tnguyenmanht-arch/amr_ws/docs/wiring-f411.html

AMR Ackermann — HUST Automotive Engineering

# Sơ đồ đấu dây STM32F411 (Black Pill)

Driver motor: DRV8871 ×2 (thay BTS7960). Servo: qua board debug TTL bus servo (thay lối đấu điện trở tạm). Tổng hợp toàn bộ pin, phân phối nguồn, và cách nối GND kiểu star — làm đúng thứ tự, không rút gọn bước nào.

2026-08-15 — Đổi driver BTS7960 → DRV8871, servo quay lại dùng board debug TTL

DRV8871 không có R_EN/L_EN (chỉ IN1/IN2 + VM/GND + OUT1/OUT2 qua terminal vít) — bỏ hẳn rail 5V từng nuôi riêng cho R_EN/L_EN của BTS7960.

Firmware không đổi gì: motor_driver.c vốn điều khiển kiểu "PWM 1 chân, chân kia = 0" — DRV8871 IN1/IN2 dùng đúng interface này. servo_buslinker.c vốn gửi khung BusLinker qua USART1, đúng giao thức board debug hiểu — lối đấu điện trở trước đây chỉ là bản chữa cháy khi board debug gốc hỏng.

⚠️ Board debug servo (BusLinker-V2.5) — KHÔNG cấp 5V ngoài vào chân 5V header

Theo user manual chính hãng (reference/TTL Bus Servo Debugging Board/): board chỉ có 1 đường nguồn vào duy nhất — terminal vít Vin (5~14V) + GND. Header 4 chân 5V TX RX GND là cổng nối vi điều khiển ngoài — chân 5V ở đây là OUTPUT do IC ổn áp trên board tự tạo ra từ Vin, không phải input cần cấp nguồn.

Nếu bơm thêm nguồn 5V ngoài vào chân này, nguồn ngoài sẽ đấu đối đầu với chính IC ổn áp trên board (2 nguồn cùng cố giữ 1 điểm ở 2 giá trị) → có thể hỏng IC ổn áp. Chỉ cấp Vin/GND qua terminal, để trống chân 5V trên header. Module hạ áp 12V→5V dự phòng không cần dùng cho board này nữa.

Xác nhận trước khi tin hẳn: cấp riêng Vin/GND (chưa nối gì vào header) → đo chân 5V header, nếu tự ra ~5V mà chưa cấp gì vào đó thì đúng là output, an toàn để bỏ trống.

⚠️ Dây/đầu nối cho đường công suất — KHÔNG dùng dupont/breadboard

Phát hiện 2026-07-26 khi đấu lại board F411 (lúc còn dùng BTS7960): dây jumper/dupont (thường 26-28 AWG, đầu pin tiếp xúc diện tích nhỏ) không đủ tải dòng motor stall ~2.3A/con — gây giật cục tăng dần theo thời gian chạy (tiếp xúc kém → nóng → điện trở tăng → nóng hơn, vòng lặp tự làm xấu). Đúng gốc rễ y hệt vụ R_EN/L_EN lỏng trên F103 trước đó, chỉ khác biểu hiện. DRV8871 dùng terminal vít cho đúng các đường này nên đỡ rủi ro hơn, nhưng vẫn cần dây đủ to và vặn vít chặt.

Bắt buộc cho các đường sau: VM, GND, OUT1, OUT2 của cả 2 DRV8871, và terminal 12V của board debug servo:

- Dây tối thiểu 18-20 AWG (0.5-0.75mm²)
- Siết vít terminal chặt tay, kiểm tra lay thử không tuột — nếu không có terminal vít (đường nào vẫn phải dùng dupont) thì bắt buộc hàn

Dupont/breadboard chỉ nên dùng cho tín hiệu logic dòng thấp: PWM (PA6/PA7/PB0/PB1 → IN1/IN2), encoder, USART, SWD.

## 01Bảng chân STM32F411

Chân | Chức năng | Nối tới | Loại
PA6 | TIM3_CH1 | DRV8871 trái — IN1 | Signal
PA7 | TIM3_CH2 | DRV8871 trái — IN2 | Signal
PB0 | TIM3_CH3 | DRV8871 phải — IN1 | Signal
PB1 | TIM3_CH4 | DRV8871 phải — IN2 | Signal
PA0 | TIM2_CH1 | Encoder trái — kênh A | Signal
PA1 | TIM2_CH2 | Encoder trái — kênh B | Signal
PB6 | TIM4_CH1 | Encoder phải — kênh A (đổi từ PC6 trên F446) | Signal
PB7 | TIM4_CH2 | Encoder phải — kênh B (đổi từ PC7 trên F446) | Signal
PA9 | USART1_TX | Board debug servo — RX | Signal
PA10 | USART1_RX | Board debug servo — TX | Signal
PA2 | USART2_TX | Jetson RX / CH340 RX (lúc test) | Signal
PA3 | USART2_RX | Jetson TX / CH340 TX (lúc test) | Signal
SWCLK / SWDIO | SWD | ST-Link — nạp code | Signal
3V3 | VDD | ST-Link 3.3V — cấp nguồn logic cho chip | Power

## 02Nối GND kiểu Star

Không để dòng lớn (motor) và GND logic (STM32) đi chung 1 đoạn dây. Mỗi nhánh GND đi thẳng, riêng biệt về 1 thanh terminal block nhỏ (điểm gốc vật lý) — rồi chỉ 1 dây duy nhất từ thanh đó ra cực (–) thật của pin 12V. Đây là điểm khác biệt lớn nhất so với cách đấu cũ (GND đi xuyên qua chân board BTS7960 rồi mới ra pin — gây hỏng board 2 lần).

Thanh terminal GND (bus bar) — 1 dây duy nhất ra cực (–) Pin 12V

STM32 GNDdây riêng, không qua board nào khác

DRV8871 tráiGND

DRV8871 phảiGND

Board debug servoGND (1 dây, board tự lo GND cho servo)

Encoder trái GNDdây riêng

Encoder phải GNDdây riêng

6 nhánh độc lập — không nhánh nào nối tiếp qua nhánh khác trước khi về điểm gốc

Vì sao phải làm vậy

Nếu GND của STM32 đi chung dây với GND của board driver motor (nơi dòng motor lớn chạy qua), dòng lớn đó gây sụt áp cục bộ trên chính đoạn dây chung — điện thế "GND" mà STM32 nhìn thấy không còn thực sự là 0V nữa. Chênh lệch này tạo dòng rò qua chân GPIO, tích lũy nhiệt qua nhiều giờ test — nghi vấn chính cho việc hỏng 2 board STM32 F446 trước đây.

## 03Phân phối nguồn

Dùng breadboard/terminal nhỏ làm điểm chia cho mỗi rail — mỗi lỗ chỉ 1 dây, không nhét nhiều dây chung 1 lỗ.

Rail | Nguồn | Cấp cho
12V | Pin 3S2P (qua BMS) | VM DRV8871 trái · VM DRV8871 phải · Terminal Vin board debug servo (board tự hạ áp nội bộ, pass-through VIN servo)
5V | Không dùng nữa — DRV8871 không cần (không có R_EN/L_EN), board debug servo tự tạo 5V nội bộ từ Vin, không cần cấp ngoài (xem cảnh báo ở trên). Module hạ áp 12V→5V dự phòng, chưa cần dùng.
3.3V | ST-Link (chân 3V3 của Black Pill) | VCC encoder trái · VCC encoder phải
GND | Cực (–) pin 12V | Theo sơ đồ star ở mục 02 — không dùng rail chung kiểu daisy-chain

## 04Từng thiết bị

### DRV8871 — board trái

Terminal vít nguồn (VM/GND) có 2 vị trí/net mỗi loại (chỉ để tiện chain) — dùng 1 vị trí mỗi net là đủ, vị trí còn lại để trống.

VM | Rail 12V — terminal vít, dây ≥18-20 AWG
GND | Dây riêng → thanh terminal GND — terminal vít, dây ≥18-20 AWG
IN1 | PA6
IN2 | PA7
OUT1, OUT2 | 2 dây động lực motor trái (không phân biệt chiều) — terminal vít, dây ≥18-20 AWG

### DRV8871 — board phải

Giống hệt board trái, đổi IN1 → PB0, IN2 → PB1, OUT1/OUT2 → motor phải, GND vẫn là nhánh star riêng của board này.

### Encoder (đấu thẳng vào STM32, không qua DRV8871)

Dây | Trái | Phải
VCC | Rail 3.3V | Rail 3.3V
GND | Nhánh star riêng | Nhánh star riêng
Kênh A | PA0 | PB6
Kênh B | PA1 | PB7

### Board debug TTL bus servo (BusLinker-V2.5)

Thay lối đấu điện trở tạm trước đây. Chỉ 1 đường nguồn vào — terminal Vin (5-14V) — board tự hạ áp nội bộ, KHÔNG cấp gì vào chân 5V trên header (xem cảnh báo ở đầu trang). Header nối STM32, terminal Vin cấp công suất, 3 dây ra servo (VIN/GND/SIG). Không cắm miniUSB debug cùng lúc với header STM32 — 2 master tranh nhau lái TX/RX gây xung đột.

5V (header) | Để trống — đây là output của board, không phải input
TX (header) | PA10
RX (header) | PA9
GND (header) | Nhánh star riêng (1 dây duy nhất cho cả board, dùng chung với GND terminal)
Terminal Vin | Rail 12V (trong dải 5-14V board chấp nhận)
Servo VIN (ra) | VIN servo
Servo GND (ra) | GND servo (cùng net GND board)
Servo SIG (ra) | SIG servo

### CH340 (chỉ dùng lúc test qua máy tính)

TX | PA3
RX | PA2
GND | GND chung
VCC | Không nối — board đã có nguồn từ ST-Link

## 05Thứ tự lắp & cấp điện

1. 1Lắp điểm phân phối nguồn (breadboard/terminal) — chưa cắm nguồn thật
2. 2Đấu toàn bộ 6 nhánh GND theo sơ đồ star trước tiên — đo thông mạch giữa các điểm GND (~0Ω)
3. 3Đấu dây tín hiệu (PWM, encoder, USART) — mỗi chân STM32 đúng 1 dây, cắm thẳng hết cỡ
4. 4Đo điện trở VM/GND từng DRV8871 và Vin/GND board debug servo (chưa cấp gì) — phải cao, không chập
5. 5Cấp ST-Link (3.3V cho Black Pill) — đo lại xác nhận đúng giá trị. Board debug servo chưa cấp Vin vội, đo thử chân 5V header lúc này (phải chưa có gì)
6. 6Cấp 12V vào rail chính (DRV8871 + Vin board debug servo) — sờ thử STM32 sau 10-15 giây đầu, dừng ngay nếu ấm bất thường. Đo lại chân 5V header board debug servo, xác nhận tự ra ~5V (output) rồi mới yên tâm để trống chân đó

Cập nhật theo phiên đổi driver BTS7960 → DRV8871 + servo qua board debug TTL BusLinker-V2.5, đối chiếu user manual chính hãng (2026-08-15), phiên debug BTS7960 + migration F446 → F411, và bài học dây/đầu nối công suất 2026-07-26. Xem CLAUDE.md mục 8 để biết lịch sử đầy đủ.
