tnguyenmanht-arch/amr_ws/amr_stm32f411/Core/Src/main.c

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
/* Includes ------------------------------------------------------------------*/
#include "main.h"

/* USER CODE BEGIN Includes */
#include <stdio.h>          /* snprintf cho debug output */
#include "motor_driver.h"
#include "servo_buslinker.h"
#include "jetson_comm.h"
#include "ackermann.h"
#include "bno055_test.h"  /* Test độc lập BNO055 qua I2C1 - xem CLAUDE.md mục 8 */
#include "dwt_log.h"      /* Đo timing baseline bằng DWT (branch baseline-dwt) */
/* USER CODE END Includes */

I2C_HandleTypeDef hi2c1;

TIM_HandleTypeDef htim2;
TIM_HandleTypeDef htim3;
TIM_HandleTypeDef htim4;

UART_HandleTypeDef huart1;
UART_HandleTypeDef huart2;

/* USER CODE BEGIN PV */
static uint32_t last_odom_ms = 0;     /* Mốc thời gian gửi odom gần nhất */
static float    current_steer = 0.0f; /* Góc lái hiện tại (độ) để gửi lên Jetson */

/* ===== Watchdog lệnh $VEL từ Jetson (AN TOÀN — bắt buộc, xem giải thích ở
 * vòng lặp chính bên dưới). Nếu Jetson ngừng gửi lệnh (crash, kill node, rút
 * cáp USART2), STM32 phải tự dừng motor, không thể trông chờ Jetson luôn gửi
 * lệnh đều đặn. ===== */
#define VEL_WATCHDOG_TIMEOUT_MS   300U  /* CẦN TUNE thực nghiệm: đủ ngắn để an
                                          * toàn, đủ dài để không dừng nhầm do
                                          * jitter mạng/CPU phía Jetson */
static uint32_t last_vel_rx_ms       = 0; /* Mốc thời gian nhận $VEL hợp lệ gần nhất */
static uint8_t  vel_watchdog_tripped = 0; /* Tránh gọi SetSpeed(0,0) lặp lại mỗi vòng lặp */

/* ===== Test độc lập BNO055 (xem bno055_test.h) — CHỈ để xác nhận module
 * sống trước khi tích hợp, chưa route vào ackermann.c/jetson_comm.c. ===== */
static BNO055_TestResult bno_result;      /* Kết quả quét địa chỉ + CHIP_ID lúc init */
static uint32_t          last_imu_ms = 0; /* Mốc thời gian đọc heading gần nhất */
#define IMU_READ_INTERVAL_MS  150U        /* 1 lần/150ms, không ảnh hưởng watchdog 300ms */

/* [ĐO] Số lần đã đo overhead ghi log (tối đa DWT_OVH_SAMPLES, xem dwt_log.h) */
static uint32_t dwt_ovh_done = 0;
/* USER CODE END PV */

void SystemClock_Config(void);
static void MX_GPIO_Init(void);
static void MX_TIM2_Init(void);
static void MX_TIM3_Init(void);
static void MX_TIM4_Init(void);
static void MX_USART1_UART_Init(void);
static void MX_USART2_UART_Init(void);
static void MX_I2C1_Init(void);
/* USER CODE BEGIN PFP */
static void on_cmd_vel(float linear, float angular);
/* USER CODE END PFP */

/**
  * @brief  The application entry point.
  * @retval int
  */
int main(void)
{

  /* MCU Configuration--------------------------------------------------------*/

  /* Reset of all peripherals, Initializes the Flash interface and the Systick. */
  HAL_Init();

  /* Configure the system clock */
  SystemClock_Config();

  /* USER CODE BEGIN SysInit */
  DWT_Init();   /* [ĐO] Bật DWT CYCCNT (100 MHz -> 10 ns/tick). Chỉ đếm, chưa ghi log. */
  /* USER CODE END SysInit */

  /* Initialize all configured peripherals */
  MX_GPIO_Init();
  MX_TIM2_Init();
  MX_TIM3_Init();
  MX_TIM4_Init();
  MX_USART1_UART_Init();
  MX_USART2_UART_Init();
  MX_I2C1_Init();
  /* USER CODE BEGIN 2 */
  HAL_Delay(500);          // Đủ để các module boot, không trigger motor timeout
  DRV_Motor_Init();        // Không check return — tiếp tục dù config fail
  DRV_Servo_Init();        // Servo về vị trí trung tâm (lái thẳng)
  APP_Comm_Init(on_cmd_vel); // Bật UART2 nhận lệnh "$VEL" từ Jetson

  /* ---- Test độc lập BNO055 (tạm thời, xem bno055_test.h) ---- */
  bno_result = BNO055_Test_Init(&hi2c1);
  {
      char dbg[48];
      int n = snprintf(dbg, sizeof(dbg), "$IMU,%u,0x%02X,0x%02X\n",
                        (unsigned)bno_result.found,
                        (unsigned)(bno_result.addr8 >> 1),
                        (unsigned)bno_result.chip_id);
      if (n > 0) {
          APP_Comm_DebugPrint(dbg); /* Gửi qua USART2 -> đọc được qua CH340 */
      }
  }
  /* USER CODE END 2 */

  /* Infinite loop */
  /* USER CODE BEGIN WHILE */
  while (1)
  {
    /* USER CODE END WHILE */

    /* USER CODE BEGIN 3 */
	  /* ---- Gửi odometry lên Jetson định kỳ mỗi 10ms (100 Hz) ---- */
	  uint32_t now = HAL_GetTick();
	  if (now - last_odom_ms >= 10U) {
		  last_odom_ms = now;

		  /* Đọc encoder 2 bánh */
		  int32_t enc_l = 0, enc_r = 0;
		  DRV_Motor_GetEncoder(&enc_l, &enc_r);

		  /* Gửi "$ODO,enc_l,enc_r,steer\n" lên Jetson */
		  /* [ĐO] EV_ODO bao trọn snprintf + gửi polling, len = số byte thật */
		  uint32_t dwt_t0 = DWT_Now();
		  int odo_len = APP_Comm_SendOdom(enc_l, enc_r, current_steer);
		  DWT_Log(EV_ODO, dwt_t0, DWT_Now(), (uint16_t)odo_len);

		  /* [ĐO] Đo chi phí của chính việc ghi log, chỉ DWT_OVH_SAMPLES lần đầu
		   * phiên đo (để không tốn chỗ trong buffer). EV_LOG_OVH bao trọn đúng
		   * 1 lần ghi bản ghi rỗng EV_DUMMY -> thời lượng của nó = chi phí
		   * 1 lần DWT_Log() + 1 lần DWT_Now(). */
		  if (log_active == DWT_LOG_RUN && dwt_ovh_done < DWT_OVH_SAMPLES) {
			  dwt_ovh_done++;
			  uint32_t dwt_ta = DWT_Now();
			  DWT_Log(EV_DUMMY, dwt_ta, dwt_ta, 0u);
			  DWT_Log(EV_LOG_OVH, dwt_ta, DWT_Now(), 0u);
		  }
	  }

	  /* ---- Vòng PID tốc độ 2 bánh (closed-loop, xem motor_driver.c/motor_pid.h).
	   * Tự throttle bên trong theo chu kỳ riêng, gọi mỗi vòng lặp không tốn gì
	   * khi chưa tới lúc. ---- */
	  DRV_Motor_UpdatePID();

	  /* ---- Xử lý lệnh "$VEL" nhận từ Jetson (gọi on_cmd_vel khi đủ frame) ---- */
	  APP_Comm_Parse();

	  /* [ĐO] Bắt đầu ghi log khi nhận $VEL hợp lệ ĐẦU TIÊN -- tránh buffer bị
	   * lấp đầy bởi giai đoạn chờ (xe đứng yên) trước khi script gửi lệnh. */
	  if (log_active == DWT_LOG_IDLE && last_vel_rx_ms != 0U) {
		  DWT_LogStart();
	  }

	  /* ---- AN TOÀN: watchdog $VEL — xem giải thích đầy đủ ở khai báo biến
	   * last_vel_rx_ms phía trên.
	   * ⚠️ BẮT BUỘC đọc lại HAL_GetTick() Ở ĐÂY, KHÔNG dùng biến 'now' chụp từ
	   * đầu vòng lặp (bug đã sửa 2026-09-05): APP_Comm_Parse() ở trên đặt
	   * last_vel_rx_ms = HAL_GetTick() tại thời điểm MỚI HƠN 'now' (do
	   * APP_Comm_SendOdom blocking ~2-3ms xen giữa). Khi last_vel_rx_ms > now,
	   * phép trừ unsigned TRÀN XUỐNG ~4.29 tỷ > 300 -> watchdog trip OAN ngay
	   * sau mỗi lệnh $VEL hợp lệ, cắt động cơ liên tục (biểu hiện: xe giật cục
	   * dù comm hoàn toàn tốt — $VEL nhận + parse 100% thành công). ---- */
	  uint32_t now_wd = HAL_GetTick();
	  if (last_vel_rx_ms != 0U && !vel_watchdog_tripped &&
	      (now_wd - last_vel_rx_ms) > VEL_WATCHDOG_TIMEOUT_MS) {
		  DRV_Motor_SetSpeed(0, 0);
		  vel_watchdog_tripped = 1U;
		  /* [ĐO] Script ngừng gửi $VEL -> kết thúc phiên đo, log_buf đứng yên
		   * để dump. Chỉ ĐỌC sự kiện watchdog, không đổi logic watchdog. */
		  DWT_LogStop();
	  }

	  /* ---- Test độc lập BNO055: đọc heading tối đa 1 lần/150ms, đặt SAU
	   * logic động cơ/servo, KHÔNG dùng HAL_Delay lớn -- không ảnh hưởng
	   * watchdog $VEL 300ms. Chỉ đọc nếu Init đã báo found=1. ---- */
	  if (bno_result.found && (now - last_imu_ms >= IMU_READ_INTERVAL_MS)) {
		  last_imu_ms = now;
		  float heading = 0.0f;
		  if (BNO055_Test_ReadHeading(&hi2c1, bno_result.addr8, &heading) == HAL_OK) {
			  char dbg[32];
			  int n = snprintf(dbg, sizeof(dbg), "$IMUH,%.1f\n", (double)heading);
			  if (n > 0) {
				  /* [ĐO] EV_IMUH chỉ bao lần gửi polling (không gồm đọc I2C) */
				  uint32_t dwt_t1 = DWT_Now();
				  APP_Comm_DebugPrint(dbg);
				  DWT_Log(EV_IMUH, dwt_t1, DWT_Now(), (uint16_t)n);
			  }
		  }
	  }
  }
  /* USER CODE END 3 */
}

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
/* USER CODE BEGIN 4 */
/**
 * @brief  Callback nhận lệnh cmd_vel từ Jetson qua UART2.
 *         Gọi tự động từ APP_Comm_Parse() khi parse đủ 1 lệnh "$VEL" hợp lệ.
 * @note   Quy đổi Twist -> Ackermann nằm trong CALC_Ackermann (ackermann.c).
 *         Kiểm tra chiều quay motor và chiều lái servo trước khi chạy tự động.
 */
static void on_cmd_vel(float linear, float angular)
{
    int8_t spd_l, spd_r;
    /* Quy đổi cmd_vel -> tốc độ 2 bánh + góc lái; lưu góc lái để gửi odom */
    CALC_Ackermann(linear, angular, &spd_l, &spd_r, &current_steer);

    DRV_Motor_SetSpeed(spd_l, spd_r);
    DRV_Servo_SetAngle(current_steer);

    /* AN TOÀN: ghi nhận mốc thời gian nhận $VEL hợp lệ, reset cờ watchdog để
     * lần mất kết nối SAU vẫn phát hiện được (xem watchdog trong vòng lặp
     * chính, khai báo biến ở USER CODE PV). */
    last_vel_rx_ms       = HAL_GetTick();
    vel_watchdog_tripped = 0U;
}
/* USER CODE END 4 */
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
