tnguyenmanht-arch/amr_ws/amr_stm32f411/Core/Inc/motor_driver.h

#ifndef __MOTOR_DRIVER_H__
#define __MOTOR_DRIVER_H__

#ifdef __cplusplus
extern "C" {
#endif

#include "main.h"
#include <stdint.h>

/* ===== Driver: BTS7960 (RPWM/LPWM), điều khiển qua TIM3 =====
 * Trái  : RPWM=PA6 (TIM3_CH1), LPWM=PA7 (TIM3_CH2)
 * Phải  : RPWM=PB0 (TIM3_CH3), LPWM=PB1 (TIM3_CH4)
 * R_EN/L_EN của cả 2 board nối cứng lên 5V (luôn bật), không điều khiển từ STM32.
 *
 * Encoder JGB37-520 đấu THẲNG vào STM32 (không qua BTS7960):
 * Trái  : A=PA0, B=PA1  -> TIM2 encoder mode (32-bit)
 * Phải  : A=PB6, B=PB7  -> TIM4 encoder mode (16-bit, cần cộng dồn tràn số trong code)
 *         (F411 không có TIM8 như F446 -> dùng TIM4 thay thế)
 */

/**
 * @brief  Khởi tạo motor driver: start PWM (duty=0) + start encoder timers.
 * @note   Gọi 1 lần sau MX_TIM2_Init()/MX_TIM3_Init()/MX_TIM4_Init() trong main.c.
 */
HAL_StatusTypeDef DRV_Motor_Init(void);

/**
 * @brief  Đặt TỐC ĐỘ MỤC TIÊU cho 2 bánh (không phải duty trực tiếp nữa).
 * @param  left   Tốc độ mục tiêu bánh trái:  -100 (lùi full) .. 0 .. 100 (tiến full)
 * @param  right  Tốc độ mục tiêu bánh phải: -100 (lùi full) .. 0 .. 100 (tiến full)
 * @note   Từ 2026-09: closed-loop qua PID (xem motor_pid.h) — hàm này chỉ LƯU
 *         mục tiêu, PWM thực tế được DRV_Motor_UpdatePID() tính lại mỗi chu kỳ
 *         dựa trên encoder, để bù ma sát/tải không đều giữa các vòng quay
 *         (giảm giật cục so với ánh xạ thẳng % -> duty trước đây).
 *         Interface (-100..100) giữ nguyên nên jetson_comm.c/ackermann.c
 *         không cần sửa gì.
 * @note   Nếu bánh chạy ngược chiều mong muốn, đảo dấu ở đây (không cần tháo dây).
 */
HAL_StatusTypeDef DRV_Motor_SetSpeed(int8_t left, int8_t right);

/**
 * @brief  Chạy 1 bước vòng lặp PID tốc độ cho cả 2 bánh.
 * @note   Tự throttle bên trong theo chu kỳ cố định (xem PID_INTERVAL_MS
 *         trong motor_driver.c) — gọi hàm này ở MỌI vòng lặp while(1) trong
 *         main.c là an toàn và không tốn gì khi chưa tới chu kỳ.
 */
void DRV_Motor_UpdatePID(void);

/**
 * @brief  Đọc tổng xung encoder tích lũy từ 2 bánh.
 * @param  left   [out] Xung encoder bánh trái  (int32, tích lũy)
 * @param  right  [out] Xung encoder bánh phải (int32, tích lũy)
 */
HAL_StatusTypeDef DRV_Motor_GetEncoder(int32_t *left, int32_t *right);

/**
 * @brief  Reset encoder về 0 (cả bộ đếm phần cứng lẫn biến cộng dồn phần mềm).
 */
HAL_StatusTypeDef DRV_Motor_ResetEncoder(void);

#ifdef __cplusplus
}
#endif

#endif /* __MOTOR_DRIVER_H__ */
