tnguyenmanht-arch/amr_ws/(commit log)

2026-05-12 feat: scaffold ROS2 workspace - 7 packages
    [amr.urdf.xacro]
2026-05-12 docs: cập nhật motor driver → Hiwonder 4-Ch Encoder Motor Driver (I2C)
    Thay thế SA8339 (chưa xác nhận) bằng module Hiwonder thực tế.
    Giao tiếp: I2C thay vì GPIO+PWM.
2026-05-12 chore(hardware): ghi chú I2C Hiwonder motor driver trong serial_driver_node
    STM32 điều khiển motor qua I2C tới Hiwonder 4-Ch Encoder Motor Driver,
    không phải PWM trực tiếp. Nhắc nhở khi viết firmware.
2026-05-12 feat: cập nhật thông số kích thước xe thực tế
    - base: 304×268×84 mm
    - wheel_radius: 100 mm, wheel_width: 29 mm
    - wheelbase: 210 mm, track_width: 217 mm
    - nav2 robot_radius: 0.21 m (circumscribed)
    - Cập nhật inertia URDF theo kích thước mới
    [amr.urdf.xacro]
2026-05-12 docs(hardware): cập nhật kiến trúc servo — HTS-20H qua TTL Bus Servo Board
    STM32 điều khiển HTS-20H thông qua Hiwonder TTL Bus Servo Debugging Board
    (STM32 USART TTL → TTL Board → HTS-20H Serial Bus), không kết nối trực tiếp.
    Cập nhật CLAUDE.md, serial_driver.hpp, serial_driver_node.cpp, amr_hardware/README.md.
2026-05-12 docs: cập nhật CLAUDE.md — trạng thái dự án + hardware đã xác nhận
    - Giai đoạn 1 hoàn thành: repo, SSH Jetson, ROS2, colcon build OK
    - Bổ sung STM32 pin assignments (I2C1, USART1, USART2)
    - Bổ sung motor driver register map (0x14, 0x15, 0x33, 0x3C)
    - Quyết định kỹ thuật đã chốt toàn bộ hardware
    - Thêm meshes/.gitkeep cho amr_description
2026-05-13 docs: update project status - Phase 2 complete, hardware confirmed
    Mark STM32 firmware phase as complete. Document confirmed hardware:
    - USART1 on PA9/PA10 (not PB6), I2C1 needs GPIO_PULLUP
    - Motor CH1=left CH2=right, BusLinker LEN=7 protocol fix
    Add "Loi da gap va fix" section to capture lessons learned.
    Next step: amr_hardware ROS2 node on Jetson.
2026-05-14 feat(hardware): serial_driver_node binary protocol STM32 Jetson
2026-05-14 feat(lidar): add sllidar_ros2 package, RPLidar A1M8 OK
2026-05-14 docs: cập nhật trạng thái dự án — Giai đoạn 4 SLAM đang triển khai
    - Giai đoạn 3 ROS2 Hardware Nodes: đánh dấu HOÀN THÀNH
    - Giai đoạn 4 SLAM: chuyển từ CHƯA BẮT ĐẦU → ĐANG TRIỂN KHAI
    - Cài ros-humble-slam-toolbox
    - slam_toolbox_params.yaml (async, 5cm, Ceres solver)
    - slam.launch.py (4 node: serial_driver, sllidar, slam_toolbox, static_tf)
    - colcon build amr_slam thành công
2026-05-14 feat(slam): cập nhật slam.launch.py — thêm 4 node đầy đủ
    Bổ sung 3 node còn thiếu vào launch file:
    - serial_driver_node (amr_hardware): STM32 /dev/stm32, 115200 baud
    - sllidar_node (sllidar_ros2): /dev/ttyUSB0, frame_id=laser_frame
    - static_transform_publisher: base_link → laser_frame (x=0.15, z=0.10)
2026-06-14 fix: correct wheel inertia values for simulation
    [amr.urdf.xacro]
2026-06-14 fix: correct wheel radius 100mm->50mm and wheel lateral position
    [amr.urdf.xacro]
2026-06-14 fix: set track_width 0.217m, frame width 0.158m, add wheel_inner_gap
    [amr.urdf.xacro]
2026-06-14 fix: recompute base_link and wheel inertia for new dimensions
    [amr.urdf.xacro]
2026-06-14 fix: update chassis dimensions L=297mm H=62mm ground_clearance=22mm
    [amr.urdf.xacro]
2026-06-15 refactor(amr_description): tách amr.urdf.xacro thành cấu trúc modular
    - inertial_macros.xacro: macro inertial_box và inertial_cylinder (thay thế giá trị hardcode)
    - amr_core.xacro: properties, materials, base_link, wheel macro + 4 bánh
    - lidar.xacro: laser_frame + laser_joint
    - camera.xacro: camera_frame, camera_optical_frame và các joint
    - ros2_control.xacro: skeleton trống cho giai đoạn Nav2
    - amr.urdf.xacro: chỉ còn <robot> root + 5 xacro:include
    [amr.urdf.xacro, amr_core.xacro, camera.xacro, inertial_macros.xacro, lidar.xacro, ros2_control.xacro]
2026-06-15 feat(amr_description): thêm Gazebo Fortress simulation support
    URDF:
    - amr_core.xacro: tách steering_wheel macro riêng (front_left/right_steer_joint
    revolute ±30°), thêm <gazebo> friction mu1=1.0/mu2=0.5 cho 4 bánh, màu links
    - ros2_control.xacro: IgnitionSystem plugin với velocity cmd bánh sau,
    position cmd steer joints, passive state-only cho bánh trước
    Config:
    - config/controller_gz_sim.yaml: AckermannSteeringController + JointStateBroadcaster
    (wheelbase=0.21m, track=0.217m, r=0.05m)
    - config/gz_bridge.yaml: bridge /cmd_vel /odom /scan /clock /joint_states /tf
    Launch:
    - launch/gazebo.launch.py: robot_state_publisher → ign gazebo → spawn
    → controllers (jsb tr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
    [amr_core.xacro, controller_gz_sim.yaml, ros2_control.xacro]
2026-06-15 fix(amr_description): thêm IGN_GAZEBO_SYSTEM_PLUGIN_PATH vào gazebo.launch.py
    SetEnvironmentVariable đặt trước node ign_gazebo để Gazebo tìm được
    libign_ros2_control-system.so khi load robot URDF.
2026-06-15 fix(amr_description): sửa tên class Gazebo plugin ign_ros2_control
    IgnRos2ControlPlugin → IgnitionROS2ControlPlugin
    (tên đúng trong libign_ros2_control-system.so)
    [ros2_control.xacro]
2026-06-15 fix(amr_description): sửa tên param string_array trong controller_gz_sim.yaml
    steering_joints → steering_joints_names
    traction_joints → rear_wheels_names
    Đúng theo AckermannSteeringController parameter interface.
    [controller_gz_sim.yaml]
2026-06-15 fix(amr_description): sửa hoàn toàn params ackermann_steering_controller
    Chẩn đoán từ steering_controllers_library_parameters.hpp và
    ackermann_steering_controller_parameters.hpp:
    Sai → Đúng:
    steering_joints_names → front_wheels_names (tên thực trong parent class)
    wheel_radius → front_wheels_radius + rear_wheels_radius (2 param riêng)
    (thiếu) → front_wheel_track (required, gt 0.0)
    (thiếu) → rear_wheel_track (required, gt 0.0)
    linear/angular limits → xóa (không tồn tại trong controller interface)
    Thêm optional params: position_feedback, velocity_rolling_window_size,
    reduce_wheel_speed_until_s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
    [controller_gz_sim.yaml]
2026-06-16 feat(amr_description): merge quy ước trục Z bánh xe + steering joints từ repo bạn bè
    - amr_core.xacro: đổi trục quay bánh xe Y -> Z (frame xoay -90° quanh X
    qua origin của joint), thêm param mirrored cho bánh đối xứng
    - steer_link đặt tại mặt phẳng base_link (z=0), kingpin lái axis Z
    - giữ nguyên tên links/joints, wheelbase=0.21, track=0.217, kích thước
    - controller_gz_sim.yaml: sửa tên param theo steering_controllers_library
    (traction_joints_names/steering_joints_names/traction_track_width/...)
    khớp version controller đã cài -> fix lỗi "string_array got [not set]"
    [amr_core.xacro, controller_gz_sim.yaml]
2026-06-17 refactor: move STM32 firmware to firmware/ subfolder
2026-06-18 feat: rewrite firmware - ASCII protocol, ackermann, proper main loop
    - motor_driver: DRV_Motor_Init dừng motor trước, ghi MOTOR_TYPE/POLARITY
    chỉ 1 byte, bỏ qua lỗi config (không return), reset encoder
    - jetson_comm: chuyển sang ASCII protocol ($VEL nhận / $ODO gửi),
    parse theo dòng, sscanf/snprintf
    - ackermann: thêm CALC_Ackermann quy đổi cmd_vel -> speed + góc lái
    - main: main loop thật 10ms (gửi odom + parse cmd_vel), bỏ code test encoder
    [jetson_comm.h, main.c, motor_driver.c]
2026-06-18 fix: UART2 RX deadlock - HAL_Transmit blocking conflicts with Receive_IT
    Root cause: HAL_UART_Transmit (blocking, used in SendOdom at 100Hz)
    locks huart2 for ~1.5ms per call. If $VEL byte arrives during lock,
    RxCpltCallback's re-arm call gets HAL_BUSY and never retries ->
    RX permanently dead while TX continues normally.
    Fix: raw register TX (bypass HAL Lock) + auto re-arm RX watchdog
    in APP_Comm_Parse + ErrorCallback clears ORE/FE flags.
    [jetson_comm.h, main.c]
2026-06-19 milestone: I2C bit-bang encoder read WORKING - GPIO_SPEED_FREQ_LOW is the key fix (resolves slave NAK from signal ringing on VERY_HIGH slew rate)
    [main.c, motor_driver.c, motor_driver.h]
2026-06-19 docs: add I2C bit-bang hardware lessons
2026-07-02 docs: update CLAUDE.md — servo direct-wire workaround, protocol mismatch found in amr_hardware
    - Xác nhận đã thay TTL Bus Servo Debugging Board (hỏng) bằng đấu trực tiếp
    STM32<->HTS-20H qua điện trở nối tiếp trên PA9, verify servo xoay đúng góc
    bằng $VEL, kể cả khi chạy đồng thời với motor (test tổ hợp 0 lỗi)
    - Đánh dấu xong: test encoder thực tế, protocol ASCII $VEL/$ODO (Giai đoạn 2)
    - Hạ Giai đoạn 3 xuống ĐANG TRIỂN KHAI: phát hiện serial_driver.hpp/stm32_comm.cpp
    (amr_hardware) vẫn dùng protocol nhị phân cũ (0xAA 0x55, CRC XOR), không tương
    thích với firmware ASCII hiện tại -> /odom sẽ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
2026-07-02 fix(amr_description): chuyển sang gz_ros2_control, thêm cmd_vel relay + teleop raw mode
    Gazebo Sim (không phải Fortress) cần plugin gz_ros2_control/GazeboSimSystem
    thay vì ign_ros2_control cũ. Sửa tên param theo API mới của
    ackermann_steering_controller v2.53.1, nạp param qua --param-file vì
    <parameters> trong URDF không truyền được tới controller. Thêm cmd_vel_relay
    vì controller mới chỉ nghe ~/reference_unstamped, không nghe /cmd_vel trực
    tiếp. Thêm script teleop_relay.py đọc phím raw mode làm phương án dự phòng
    cho teleop_twist_keyboard hay bị kẹt cooked mode.
    [controller_gz_sim.yaml, ros2_control.xacro]
2026-07-02 feat(amr_hardware): viết lại SerialDriver sang ASCII protocol, khớp firmware $VEL/$ODO
    Protocol nhị phân cũ (0xAA 0x55, CRC XOR) không tương thích với firmware
    STM32 hiện tại đã đổi sang ASCII line-based. Viết lại sendCmdVel/readOdom
    sang "$VEL,%.2f,%.2f\n" / parse "$ODO,%ld,%ld,%f", thêm publisher
    /steering_angle. Verify trên Jetson + STM32 thật: /odom 20Hz, TF đúng,
    servo phản hồi tức thời.
    Phát hiện + fix thêm 1 bug trong lúc verify: readOdom() chỉ đọc 1 dòng
    $ODO đầu tiên rồi return mỗi lần gọi, trong khi firmware gửi 100Hz còn
    node đọc ở 20Hz -> backlog dồn lại, dữ liệu publish trễ dần theo thời
    gia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
    [serial_driver_node.cpp, stm32_comm.cpp]
2026-07-03 fix(amr_hardware): fix odom baseline jump on startup, calibrate ticks_per_rev thực nghiệm
    ENCODER_TOTAL trên mạch Hiwonder không tự reset khi node ROS2 restart, nên
    tick tích lũy từ lần chạy trước gây nhảy vọt vị trí giả tạo ở lần đọc đầu
    tiên. Fix: dùng lần đọc $ODO hợp lệ đầu tiên làm baseline (prev_left_/
    prev_right_) thay vì giả định 0.
    Hiệu chuẩn ticks_per_rev bằng đo thực tế trên khung xe đã lắp (bánh chạm
    đất): 990 (lý thuyết 11 PPR x gear 90) sai lệch ~7.9 lần so với khoảng
    cách đo tay. Cập nhật encoder_ppr=86.78 trong hardware.launch.py, verify
    lại: /odom khớp thước đo t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
    [serial_driver_node.cpp]
2026-07-03 feat(amr_hardware): tinh chỉnh calibration ticks_per_rev + thêm steering trim bù lệch servo
    Đo thêm 3 lần độc lập (0.34-0.5m) + 1 lần dài xác nhận (1.465m) để tinh
    chỉnh ticks_per_rev: 7810 -> 7885 (encoder_ppr=87.61). Verify quãng dài:
    /odom lệch chỉ ~1.4% so với thước đo.
    Phát hiện xe đi thẳng bị lệch trái ~6.3cm/m (servo lệch tâm cơ khí, không
    phải lỗi encoder). Thêm tham số steering_trim_angular_z trong
    serial_driver_node.cpp — cộng bù vào angular.z trước khi gửi $VEL, sửa ở
    phía Jetson để không cần build lại firmware STM32. Dò thực nghiệm nhiều
    điểm, nội suy ra steering_trim_angular_z=-0.0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
2026-07-03 fix(amr_description): cập nhật vị trí camera khớp lắp đặt thật (webcam USB)
    IMX-219 chưa về hàng, tạm dùng webcam USB gắn ngang mặt trước xe. Đo thực
    tế: cao 10.5cm so với mặt đất, nhô ra phía trước mép chassis 5cm, đặt
    ngang (pitch=0) — thay cho vị trí đặt giữ chỗ ban đầu (nghiêng 0.3 rad).
    [camera.xacro]
2026-07-03 feat(amr_perception): thêm camera.launch.py (webcam USB), verify lane_detection_node end-to-end
    IMX-219 chưa về hàng, tạm dùng webcam USB qua ros-humble-usb-cam
    (usb_cam_node_exe, remap /image_raw -> /camera/image_raw). Verify thực tế
    trên Jetson: camera publish ~24-25Hz, ảnh thật (không phải khung đen/lỗi).
    lane_detection_node.py (Canny+Hough, có sẵn từ lúc scaffold nhưng chưa
    từng chạy) chạy được end-to-end lần đầu: /lane_center_error và
    /lane_debug_image đều publish đúng, không crash. Test trong nhà (không có
    vạch làn thật) nên bắt nhầm vân sàn gỗ làm vạch trái -- đúng dự kiến, cần
    môi trường có vạch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
2026-07-04 fix(firmware): thêm watchdog $VEL timeout - CRITICAL safety, chưa build/nạp
    Phát hiện khi test lane_follow_node thật: kill hết node ROS trên Jetson +
    gửi cmd_vel=0 nhưng xe vẫn chạy mãi, chỉ dừng khi rút cáp USB STM32. Nguyên
    nhân: watchdog nội bộ Hiwonder Motor Driver (tự dừng nếu >2s không nhận
    I2C) bị vô hiệu hóa vì STM32 đọc encoder mỗi 10ms bất kể có $VEL mới hay
    không -> watchdog phần cứng không bao giờ kích hoạt.
    Fix: thêm watchdog riêng ở main.c - track last_vel_rx_ms trong on_cmd_vel(),
    nếu quá VEL_WATCHDOG_TIMEOUT_MS (300ms) không nhận $VEL mới thì STM32 tự
    gọi DRV_Motor_SetSpeed(0,0). CHƯA bu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
    [camera.xacro]
2026-07-05 fix(amr_perception): sửa roi_top_ratio khớp vị trí camera mới, verify firmware watchdog
    Firmware watchdog: build/nạp lên STM32 thật xong, verify bằng script Python
    theo dõi /odom chính xác theo thời gian - xe tự dừng chỉ 85ms sau khi mất
    kết nối phần mềm (nhanh hơn ngưỡng 300ms cài đặt).
    Lane detection: "mất dấu làn chập chờn" nghi ban đầu do ánh sáng, nhưng ảnh
    debug cho thấy nguyên nhân thật là roi_top_ratio=0.55 (cũ) không còn khớp
    sau khi camera đổi vị trí lần 2 - cả 2 vạch nằm ngoài/phía trên ROI. Đổi
    roi_top_ratio=0.35: /lane_center_error từ thất thường 4.7-10.9Hz (khoảng
    trống t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
2026-07-05 fix(amr_perception): hạ canny_low/high 50/150->20/60 - thiếu tương phản dưới ánh sáng hiện tại
    Test trực tiếp trên frame thật lúc lane_follow_node đang chạy: Canny ở
    ngưỡng cũ hoàn toàn không bắt được cạnh vạch trái (0 edge pixel trong ROI)
    dù vạch rõ ràng trong ảnh gốc. Hạ ngưỡng xuống 20/60: bắt được cả 2 vạch
    (11 trái/9 phải trên cùng frame). Verify /lane_center_error ổn định 26.8Hz,
    ảnh debug không thấy nhiễu rõ rệt từ vân sàn gỗ.
2026-07-05 docs: cập nhật CLAUDE.md - mạch Motor Driver Hiwonder đã cháy, cần thay mới
    Sau nhiều lần debug tưởng là lỗi phần mềm (node kẹt state), xác nhận chip
    trên mạch Motor Driver Hiwonder đã cháy thật khi tháo tản nhiệt lúc đang
    nóng. Ghi lại lịch sử debug đầy đủ để không nhầm lẫn lại là lỗi phần mềm
    ở phiên làm việc sau. Firmware watchdog và lane detection fixes vẫn giữ
    nguyên giá trị, không cần làm lại khi có driver mới.
2026-07-07 docs: cập nhật CLAUDE.md - board F411 thứ 3 hỏng khi nối Jetson, chuyển sang F103C8T6
    Nghi ngờ ground loop (Type-C + CH340 cùng cắm 2 cổng USB khác nhau của
    Jetson) nhưng CHƯA xác nhận chắc chắn. Quyết định chuyển sang
    STM32F103C8T6 Blue Pill đã có sẵn thay vì mua thêm F411. Ghi lại đầy đủ
    checklist an toàn bắt buộc cho lần lắp tiếp theo.
2026-07-07 feat(firmware): migrate STM32 slave từ F446RE sang F411CEU6 Black Pill
    2 board F446RE Nucleo hỏng liên tiếp (nghi rò AC + ground bounce tích lũy
    qua nhiều giờ test) -> chuyển sang F411CEU6 rời + ST-Link ngoài. Project
    mới hoàn toàn (amr_stm32f411/), copy ackermann/jetson_comm/servo_buslinker
    không đổi, chỉ sửa motor_driver.c (TIM8->TIM4, ARR 4499->4999 theo clock
    100MHz), bỏ đảo dấu bánh phải (quy ước dây khác F446), thêm calibration
    servo mới (ID=9, trim +1.5 do).
    Fix quan trọng nhất: thiếu cấu hình NVIC cho USART2 khi tạo project CubeMX
    mới (không tự bật như project generate lại) khiến $VEL không bao giờ được
    x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
    [amr_stm32f411.ioc, jetson_comm.h, main.c, motor_driver.c, motor_driver.h, servo_buslinker.h]
2026-07-19 feat(firmware): thêm project STM32F103C8T6 "Blue Pill" thay F411
    Board F411 thứ 3 hỏng khi nối Jetson (nghi ground loop), chuyển sang
    F103C8T6 rời có sẵn. Port từ amr_stm32f411: giữ nguyên ackermann.c/h,
    jetson_comm.c/h, servo_buslinker.c/h; viết lại motor_driver.c/h (cộng
    dồn tràn số cho cả 2 encoder vì F103 không có timer 32-bit); PWM
    ARR=3599 cho 20kHz ở 72MHz; bật NVIC USART2 và giữ Serial Wire (SWD)
    ngay từ CubeMX; thêm cờ linker -u _printf_float/_scanf_float.
    Đã verify thực tế: $VEL/$ODO, servo, watchdog, motor+encoder (kể cả
    chạy tổ hợp với servo) — vấn đề giật cục ban đầu là do tiếp xúc lỏng
    R_EN/L_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
2026-07-21 docs: cập nhật CLAUDE.md - F103 verify xong, kế hoạch thay MiniROS Controller
    STM32 slave chính thức đổi sang F103C8T6 (F411/F446 giữ tham khảo lịch
    sử). Ghi lại nguyên nhân "giật cục" motor: tiếp xúc lỏng R_EN/L_EN đo
    tay ra đủ 5V nhưng vẫn lỗi (bài học mới). Thêm kế hoạch thay thế bằng
    Hiwonder MiniROS Controller (STM32F407 + driver SA8870 tích hợp), ETA
    ~2026-08-04, đã chốt giữ kiến trúc firmware tự viết thay vì FreeRTOS
    full-stack của Hiwonder, kèm quy tắc an toàn nối Jetson (1 đường nguồn
    duy nhất) rút kinh nghiệm từ vụ F411 hỏng lần 3.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
2026-08-20 fix(firmware): sửa SERVO_ID (9→1) + đảo chiều bánh phải cho DRV8871; docs: cập nhật CLAUDE.md chuyển sang F411+DRV8871, tạm dừng MiniROS
    - servo_buslinker.h: SERVO_ID 9→1 (đổi servo, servo cũ ID=9 không còn dùng)
    - motor_driver.c: đảo dấu bánh phải trong DRV_Motor_SetSpeed cho wiring DRV8871 mới (xác nhận bằng quan sát trực tiếp)
    - docs/wiring-f411.html: sơ đồ đấu dây DRV8871 x2 + board debug servo BusLinker-V2.5 (thay BTS7960 + lối đấu điện trở)
    - CLAUDE.md: ghi nhận quyết định 2026-08-19 - dùng F411 (board mới) + DRV8871 làm hướng chính, tạm dừng kế hoạch MiniROS Controller, ghi lại điều tra gi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
    [motor_driver.c, servo_buslinker.h]
2026-08-22 test(firmware): thêm test độc lập BNO055 (IMU) qua I2C1 trên amr_stm32f411
    Chỉ là code TEST độc lập để xác nhận module BNO055 sống trước khi quyết
    định tích hợp — CHƯA route vào ackermann.c/jetson_comm.c, KHÔNG ảnh hưởng
    luồng điều khiển chính (khi module không cắm, found=0 -> không lệnh I2C
    nào chạy trong while(1), $ODO/$VEL/watchdog giữ nguyên hành vi).
    - I2C1 (PB8=SCL/PB9=SDA, Standard 100kHz, polling) cấu hình qua STM32CubeIDE
    GUI thật (Device Configuration Tool) - đã đối chiếu diff xác nhận không
    đụng TIM2/TIM3/TIM4/USART1/USART2
    - bno055_test.h/.c: quét địa chỉ 0x28/0x29, đọc CHIP_ID, chuy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
2026-08-24 feat(pcb): thêm header BNO055 vào PCB, gerber sẵn sàng gia công
    - Header 8 chân (footprint GY-BNO055), chỉ route 4 chân cần dùng:
    VIN->3.3V, GND, SCL\Rx->PB8, SDA\Tx->PB9 - RESET/INT/ADD/BOOT để trống
    (chủ động không route, xem lý do trong CLAUDE.md)
    - Track động lực M1+/M1-/M2+/M2- giữ nguyên, không đổi so với lần review
    trước
    - CLAUDE.md: ghi lại đối chiếu gerber cũ/mới qua parse track/net, xác nhận
    PCB sẵn sàng gia công
    [Stm32-B_Cu.gbr, Stm32-B_Mask.gbr, Stm32-B_Paste.gbr, Stm32-B_Silkscreen.gbr, Stm32-Edge_Cuts.gbr, Stm32-F_Cu.gbr, Stm32-F_Mask.gbr, Stm32-F_Paste.gbr]
2026-08-29 docs: lưu link artifact wiring-f411 vào CLAUDE.md + comment đầu file HTML
2026-09-05 feat(firmware): PID tốc độ closed-loop + sửa bug watchdog tràn số gây giật cục
    Thêm vòng PID (PI) điều khiển tốc độ 2 bánh sau dựa trên encoder, thay cho
    open-loop đặt duty cố định — DRV8871 không có PID nội bộ như board Hiwonder cũ.
    Bug quan trọng nhất đã sửa — watchdog $VEL trip oan do tràn số unsigned:
    biến 'now' chụp ở đầu vòng lặp, nhưng APP_Comm_Parse() phía sau đặt
    last_vel_rx_ms = HAL_GetTick() tại thời điểm mới hơn (do SendOdom blocking
    ~2-3ms xen giữa). Khi last_vel_rx_ms > now, phép trừ unsigned tràn xuống
    ~4.29 tỷ > 300ms -> watchdog cắt động cơ ngay sau MỖI lệnh hợp l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
    [main.c, motor_driver.c, motor_driver.h]
2026-09-05 docs: ghi lại bug watchdog tràn số (nguyên nhân thật của giật cục) + PID closed-loop
    - Đánh dấu "giật cục motor" ĐÃ GIẢI QUYẾT DỨT ĐIỂM: nguyên nhân là tràn số
    unsigned trong watchdog $VEL, không phải dây lỏng/driver/CH340 như nghi
    suốt nhiều tháng.
    - Ghi lại đầy đủ quá trình loại trừ (đổi CH340->CP2102, đổi sang board F103,
    đổi dây/GND/cổng đều cho triệu chứng y hệt) và bước quyết định: đếm byte
    thô cho thấy $VEL nhận + parse 100% thành công.
    - 4 bài học timing/debug rút ra, áp dụng cho code sau này.
    - Ghi lại kiến trúc PID mới, các hằng số đã hiệu chuẩ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
2026-09-05 fix(amr_hardware): bù dấu encoder trái trong /odom (xe chạy nhưng odom đứng yên)
    Firmware $ODO gửi tick THÔ đúng như timer đếm được, không bù dấu (firmware
    chỉ bù nội bộ cho vòng PID qua LEFT_ENCODER_SIGN trong motor_driver.c).
    Với wiring DRV8871 hiện tại, lệnh tiến làm enc_l chạy ÂM còn enc_r chạy
    DƯƠNG với độ lớn khớp nhau -> d=(dl+dr)/2 triệt tiêu về ~0, /odom gần như
    đứng yên dù xe chạy thật. Bug này sẽ làm hỏng SLAM/Nav2 ngay khi chạy full
    stack.
    Thêm 2 tham số ROS `left_encoder_sign`/`right_encoder_sign` (mặc định
    -1.0/+1.0) thay vì hardcode dấu âm, vì quy ước dấu đổi theo m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
    [serial_driver_node.cpp]
2026-09-05 fix(amr_hardware): hiệu chuẩn lại odometry + trim lái trên phần cứng thật
    Phát hiện wheel_radius=0.10 là ĐƯỜNG KÍNH bị ghi nhầm thành bán kính (bánh
    thật đường kính 100mm -> bán kính 0.05m; dấu hiệu: cả xe chỉ cao 84mm).
    encoder_ppr=87.61 cũ khi đó phải gấp đôi giá trị thật để bù lại, nên /odom
    vẫn ra đúng quãng đường — hai lỗi sai bù trừ nhau, từng hằng số riêng đều sai.
    Tham số hoá lại tách đại lượng RỜI RẠC CHÍNH XÁC khỏi đại lượng HIỆU CHUẨN:
    - ticks_per_rev = 44*90 = 3960 (11 PPR x 4 cạnh quadrature TI12 x gear 90:1)
    - wheel_radius = 0.049 (bán kính LĂN hi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
2026-09-05 fix(amr_hardware): hoàn nguyên mô hình xe đạp + tài liệu hoá nguyên nhân gốc understeer
    TÌM RA NGUYÊN NHÂN GỐC: firmware CALC_Ackermann đặt 2 bánh sau CÙNG tốc độ
    khi cua (*speed_l = *speed_r = spd), và PID thêm hôm nay còn ép chặt mỗi bánh
    bám setpoint đó. Hậu quả kép: xe understeer ~2 lần VÀ /odom mù về hướng.
    Đo trên xe thật (Jetson, CP2102):
    - Lái hết cỡ (steer_deg=+25.2, hình học cho R=0.364m) -> vòng tròn thật
    đường kính 1.4-1.5m (R=0.725m), rộng gấp 2 lần
    - Cua nhỏ (steer_deg=+4.2) -> xe chỉ xoay 5 độ sau 1.06m thay vì ~45 độ
    - Đi thẳng bình thường (lệch 6-7mm trên 1.09m)
    Cơ c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
    [serial_driver_node.cpp]
2026-09-06 fix(firmware): bù vi sai 2 bánh sau + góc lái theo vận tốc, sửa understeer 2x
    Nguyên nhân understeer (chẩn đoán từ phiên Jetson): CALC_Ackermann ép 2 bánh
    sau cùng tốc độ khi cua, PID lại bám chặt setpoint đó -> lốp buộc phải trượt
    ngang -> xe tự giãn bán kính. Lệnh lái 30° lẽ ra cho vòng tròn Ø0.73m, thực
    đo Ø1.45m.
    Thay bằng công thức Ackermann chuẩn (Kinematics Analysis.pdf trang 6, đã tự
    dẫn lại kiểm chứng chứ không chép):
    V_L = V·(1 − D·tanθ/2H) , V_R = V·(1 + D·tanθ/2H) (D=0.217, H=0.21)
    Góc lái đổi sang θ = atan(H·ω/v) — hằng số K_ANGULAR_TO_DEG=30 cũ bỏ quên
    vận tố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
2026-09-06 docs+fix: verify vi sai chạy đúng, hiệu chuẩn tỉ số truyền lái 0.597
    TEST VÒNG TRÒN DƯỚI SÀN (việc còn treo từ phiên Windows) — vi sai ĐẠT:
    bán kính cua 1.45 m -> 0.55 m (thu 2.6 lần)
    góc lái hiệu dụng 8.2° -> 20.9°
    hệ số understeer 3.99 -> 1.82
    Giả thuyết khoá vi sai được xác nhận là nguyên nhân chính, sửa đúng chỗ.
    PHÁT HIỆN MỚI — tay đòn lái chỉ truyền ~60% góc servo. Truy phần understeer
    còn lại bằng 2 test vòng tròn ở 2 góc khác nhau:
    servo +22.2° -> Ø1.46m -> R=0.730m -> bánh 16.05° | hệ số 0.594
    servo +30.0° -> Ø1.10m -> R=0.550m -> bánh 20.90° | hệ s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
2026-09-06 feat(firmware): tỉ số truyền lái 0.597 + trim -4.8 + tách giới hạn servo/bánh
    Cài đặt bản bàn giao từ phiên Jetson (commit 4f4a0e6), đã nạp và verify trên
    phần cứng thật (bánh nhấc, CP2102 COM9). Chi tiết đầy đủ trong CLAUDE.md, mục
    "ĐÃ LÀM XONG Ở PHIÊN WINDOWS (2026-09-06)".
    HẰNG SỐ CUỐI (ackermann.h)
    ACK_STEER_TRIM_DEG +1.5f -> -4.8f lệnh servo ứng với bánh THẲNG
    ACK_STEER_GAIN (mới) 0.597f bánh chỉ quay ~60% góc servo
    ACK_MAX_SERVO_DEG 30.0f -> 35.0f trần kỹ thuật (servo thật đi được ±120°)
    ACK_MAX_WHEEL_DEG (mới) 18.0f GIỚI HẠN THẬT: bánh chạm khung xe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
2026-09-06 fix(firmware): trim lái -4.8 -> 0.0 (đo trực tiếp dưới sàn, giá trị cũ sai 4.8°)
    ⚠️ SOURCE đã sửa, BOARD CHƯA NẠP — cần phiên Windows build + flash.
    CHẠY 2 LỖ HỔNG PHIÊN WINDOWS NÊU, KẾT QUẢ LẬT NGƯỢC CẢ HAI KẾT LUẬN TRUNG GIAN
    1) Vòng tròn bẻ hết lái 2 chiều (đo tâm trục sau, đã trừ đoạn mồi ~0.2m):
    trái servo +25.35 -> Ø1.40-1.45m -> R 0.698m -> bánh 16.73° -> GAIN 0.555
    phải servo -35.00 -> Ø1.27m -> R 0.619m -> bánh 18.73° -> GAIN 0.620
    Thoạt nhìn = bất đối xứng 12%, đúng như lỗ hổng 2 dự đoán. NHƯNG SAI (xem 3).
    2) TEST CHẠY THẲNG PHÁT HIỆN TRIM SAI T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
2026-09-06 fix(firmware): cho servo dùng hết ±35° — bỏ chặn nhầm ở phía góc bánh
    User xác minh bằng mắt: ở lệnh servo ±35° bánh vẫn hở khung 5mm, cả 2 bên như
    nhau, chạy thoải mái. 35° là mức an toàn USER TỰ CHỌN khi test, KHÔNG phải điểm
    chạm — điểm chạm thật nằm xa hơn, chưa dò tới và cũng không cần.
    VẤN ĐỀ: ACK_MAX_WHEEL_DEG=18.0 đang chặn trước, servo chỉ chạy tới 30.15° nên
    không dùng hết tầm lái đã được xác minh an toàn.
    Con số "bánh 18.03°" ở các bản trước KHÔNG phải số đo cơ khí — nó chính là
    servo 35° quy đổi qua ACK_STEER_GAIN. Mà GAIN nay đã bi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
2026-09-06 feat(firmware): ACK_STEER_GAIN 0.597 -> 0.566 (đo lại trên trim đúng)
    TRIM=0.0 ĐÃ NẠP + VERIFY DƯỚI SÀN
    servo giữa đọc về 0.00°; đối xứng tuyệt đối từng bước ±8.5/±16.6/±25.1/
    ±30.2/±35.0; bão hoà đúng ±35.0. Chạy thẳng lệch 2cm/1.18m (góc bánh dư
    0.34°, trước khi sửa 2.05°) -> trim ĐÚNG.
    An toàn: user xác minh bằng mắt ở ±35° KHÔNG bánh nào chạm khung.
    ĐO LẠI GAIN trên điểm gốc đúng (vòng tròn bẻ hết lái, đo TÂM TRỤC SAU,
    trừ đoạn mồi ~0.2m):
    TRÁI Ø1.19m -> R 0.578 -> bánh 19.96° -> 0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
2026-09-08 feat(slam): sẵn sàng vẽ bản đồ — sửa hằng số sai, đo vị trí LiDAR, thêm script
    Sửa 3 lỗi chặn đường trước khi chạy SLAM được:
    1. slam.launch.py TỰ KHAI BÁO LẠI serial_driver_node với bộ tham số riêng,
    và bộ đó đã lỗi thời từ 2026-09-05: wheel_radius=0.10 (lỗi đường-kính-
    nhầm-bán-kính), encoder_ppr=11, THIẾU track_width và encoder sign. Chạy
    SLAM bằng file đó sẽ vứt bỏ toàn bộ hiệu chuẩn — /odom vừa sai quãng
    đường ~8 lần vừa đứng yên hoàn toàn. Nay INCLUDE hardware.launch.py nên
    hiệu chuẩn chỉ tồn tại ở MỘT chỗ, không thể lệch pha giữ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
2026-09-08 fix(scripts): dừng hẳn nếu không nhận diện được cổng, thay vì chạy tiếp với biến rỗng
2026-09-08 docs(slam): Giai đoạn 4 SLAM HOÀN THÀNH + lưu bản đồ + kế hoạch Nav2 chi tiết
    - SLAM chạy thật xong: cả hệ chạy đồng thời 0 lỗi, quét 1 vòng đóng vòng OK.
    - Lưu maps/map_20260909_0000.pgm+.yaml (~23m2, gần như toàn bộ vùng đi được).
    - Ghi lại đầy đủ buổi SLAM: bug slam.launch.py (bản sao tham số cũ -> INCLUDE
    hardware.launch), wheel_radius 0.049->0.050, LiDAR yaw=180 (lắp quay ngược,
    xác định bằng dữ liệu), x=0.205/z=0.135, min_laser_range 0.28, vùng mù 70°
    sau đuôi do PCB+Jetson, workflow SSH không dây + claude --continue, scripts/.
    - Viết kế hoạch Nav2 (Giai đoạn 5) chi tiết: Smac Hybr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
2026-09-09 feat(nav2): sửa 5 lỗi chặn đường trong scaffold nav2 + viết lại launch
    nav2_params.yaml và navigation.launch.py đã tồn tại từ lúc scaffold workspace
    (CLAUDE.md ghi Giai đoạn 5 "CHƯA BẮT ĐẦU" nên tưởng phải viết mới). Đọc kỹ thì
    đó là bản chép từ nav2_bringup mặc định — đúng kiểu bẫy đã cắn hôm qua ở
    slam.launch.py. 5 lỗi, mỗi lỗi đều đủ để phá Nav2 ngay khi chạy:
    1. planner = nav2_navfn_planner/NavfnPlanner (Dijkstra/A* 2D) -> đổi sang
    nav2_smac_planner/SmacPlannerHybrid, minimum_turning_radius=0.583 (số ĐO
    THẬT), motion_model=DUBIN (chỉ tiến — xe mù 70° hướng lùi).
    Na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
2026-09-09 fix(nav2): Nav2 khởi động được — sửa BT plugin thiếu, AMCL initial pose, reset LiDAR
    Test tĩnh trên xe thật, tìm và sửa 2 lỗi nữa (ngoài 5 lỗi ở commit trước):
    6. bt_navigator CHẾT lúc configure: plugin_lib_names khai báo 2 thư viện KHÔNG
    tồn tại trong Nav2 Humble (nav2_goal_update_action_bt_node,
    nav2_navigate_to_charging_station_action_bt_node — thuộc bản mới hơn).
    Hậu quả: lifecycle_manager HUỶ TOÀN BỘ bringup ("Aborting bringup").
    Đã đối chiếu từng dòng với /opt/ros/humble/lib/, bỏ 2 dòng sai + thêm 5 thư
    viện có sẵn mà scaffold bỏ sót. Nay 50/50 thư viện đều tồn tại thậ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
    [lidar_reset.py, usb_reset.py]
2026-09-09 feat(nav2): thêm scripts/rviz_nav.sh để đặt vị trí ban đầu + chọn đích bằng chuột
    Xe KHÔNG đứng ở gốc bản đồ (user xác nhận), nên set_initial_pose (0,0,0) chỉ
    để Nav2 khởi động được — phải sửa lại tư thế thật bằng '2D Pose Estimate'.
    ⚠️ Đính chính: kết luận trước đó 'vòng quét khớp bản đồ 83% -> xe ở đúng gốc'
    là SUY LUẬN VÒNG TRÒN. So /scan với costmap, mà costmap có obstacle_layer dựng
    TỪ CHÍNH /scan đó (chiếu qua TF đang giả định xe ở gốc) -> tia nào cũng trúng.
    Muốn kiểm chứng đúng phải so với BẢN ĐỒ TĨNH đã lưu. Đây là lần thứ hai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
2026-09-09 docs(nav2): chốt tiến độ Giai đoạn 5 — Nav2 khởi động được, 7 lỗi scaffold, việc còn lại
    Cập nhật Giai đoạn 5 từ 'CHƯA BẮT ĐẦU' -> 'ĐANG TRIỂN KHAI, test tĩnh ĐẠT'.
    Ghi đầy đủ 7 lỗi trong scaffold nav2 + kết quả test tĩnh + 2 phép đo SAI của
    Claude trong buổi này (suy luận vòng tròn lần thứ hai; nhầm thang costmap
    0-255 với thang publish 0-100).
    Việc còn lại: (1) chưa biết xe ở đâu trên bản đồ — cần viết dò tự động hoặc
    dùng RViz; (2) tư vấn truy cập RViz từ laptop Windows (VNC thay vì ssh -X).
2026-09-29 docs: chuyển slave sang Hiwonder ROS Robot Controller (STM32F407VET6)
    - Thêm mục mới ở mục 8: nguồn, quy trình kết nối an toàn, sơ đồ chân
    đối chiếu schematic V1.1, rủi ro, ảnh hưởng tới firmware
    - Đánh dấu F411 + DRV8871 + BusLinker là phần cứng cũ
    - Ghi rõ board này KHÁC board MiniROS (bản Mini)
2026-09-29 feat(f411): hạ tầng đo timing DWT cho baseline superloop (chưa nạp)
    - dwt_log.c/h: ring buffer 5000 bản ghi trong RAM, không ghi đè, tự
    bắt đầu ở $VEL đầu tiên và tự dừng khi watchdog $VEL trip
    - Điểm đo EV_PID / EV_ODO (kèm độ dài khung) / EV_IMUH / overhead
    - APP_Comm_SendOdom trả về số byte đã gửi (hành vi không đổi)
    - scripts: send_vel_loop.py, dump_baseline.py, analyze_baseline.py,
    hướng dẫn BASELINE_DWT.md
    Build Debug/Release 0 lỗi 0 warning. Sẽ port sang F407.
2026-09-29 feat(f407): project CubeMX + port firmware sang Hiwonder ROS Robot Controller
    - amr_stm32f407.ioc sinh bằng CubeMX 6.16.1 (CLI): HSE 8MHz -> 168MHz,
    Serial Wire, TIM1 PWM 20kHz (M1 PE13/PE14, M2 PE9/PE11), encoder
    TIM5 (PA0/PA1) + TIM2 (PA15/PB3) 32-bit, USART3 (Jetson) + USART6
    (bus servo) có NVIC, USART1, I2C2 (MPU-6050), ADC1_IN8 (pin, 480 cycles)
    - jetson_comm: USART2 -> USART3 qua macro COMM_HUART/COMM_USART
    - servo_buslinker: USART6 + đảo chiều bộ đệm 74LVC2G125 (PE7/PE8)
    - motor_driver: TIM1 + 2 encoder 32-bit, bỏ cộng dồn tràn số; chiều
    FWD/REV và dấu encoder để macro, CHƯA đo trên board mới
    - main.c: logic giống F411 (watchdog now_wd, DWT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
2026-09-29 feat(f407): chế độ bring-up + checklist ngày hàng về
    - bringup.c/h: giữ K1 khi reset -> menu kiểm tra qua USART1 + USART3
    (banner riêng từng cổng), trạng thái PD3/K1/K2/VBAT/encoder, quét
    I2C2 + WHO_AM_I MPU-6050, test chiều từng bánh open-loop 25% 1s,
    đo tick/10ms tối đa, quét servo, đổi cực tính OE bộ đệm servo.
    Motor chỉ chạy khi gõ lệnh, tự dừng, phím bất kỳ dừng ngay.
    - motor_driver: DRV_Motor_SetDutyRaw (chỉ cho bring-up, bỏ qua PID)
    - servo_buslinker: DRV_Servo_SetBufferActiveLow
    - docs/bringup-f407.md: checklist A-D, ghi kết quả để điền hằng số
    - CLAUDE.md: trạng thái f407-port + mẹo CubeMX CL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
    [main.c, motor_driver.c, motor_driver.h, servo_buslinker.h]
2026-09-30 feat(osek): toolchain Trampoline tren Windows + hard float cho stm32f407
    - docs/trampoline-setup.md: cai goil (WinLibs GCC), build, 3 ban va, quy tac USEFLOAT
    - scripts/trampoline_build.sh: build 1 app OIL (chi build, khong nap)
    - amr_trampoline/patches: ban va Trampoline (branch amr-f407)
    - amr_trampoline/fpu_check: app kiem tra luu ngu canh FPU giua 2 task
2026-09-30 docs(daks): doi huong do an sang mang ECU CAN tren ban
    - CLAUDE.md: muc 'Huong do an tu 30/9/2026'; xe AMR quay lai F411+DRV8871
    (du an ca nhan), board Hiwonder la ECU1 VCU; danh dau ke hoach cu
    (baseline tren xe, E1-E4, DACN UART-DMA) khong con thuoc do an
    - docs/can-network-architecture.md: kien truc, nguyen tac module, dai ID,
    CAN matrix, phan cung, cach dau bus, de xuat cau truc thu muc (cho duyet)
    - can/vehicle.dbc: ban nhap 0.1 (4 message), kiem bang cantools,
    tai bus ly thuyet 3.0% o 500 kbit/s
    Chua co firmware, chua nap code.
