tnguyenmanht-arch/amr_ws/(notices)

Notices in the files:
amr_stm32f411/Core/Src/main.c:
Copyright (c) 2026 STMicroelectronics.
All rights reserved.
This software is licensed under terms that can be found in the LICENSE file
